felipepipe18/openesc/hardware/projects/OpenESC.sch

## KiCad design hardware/projects/OpenESC.sch (2012-09-12)

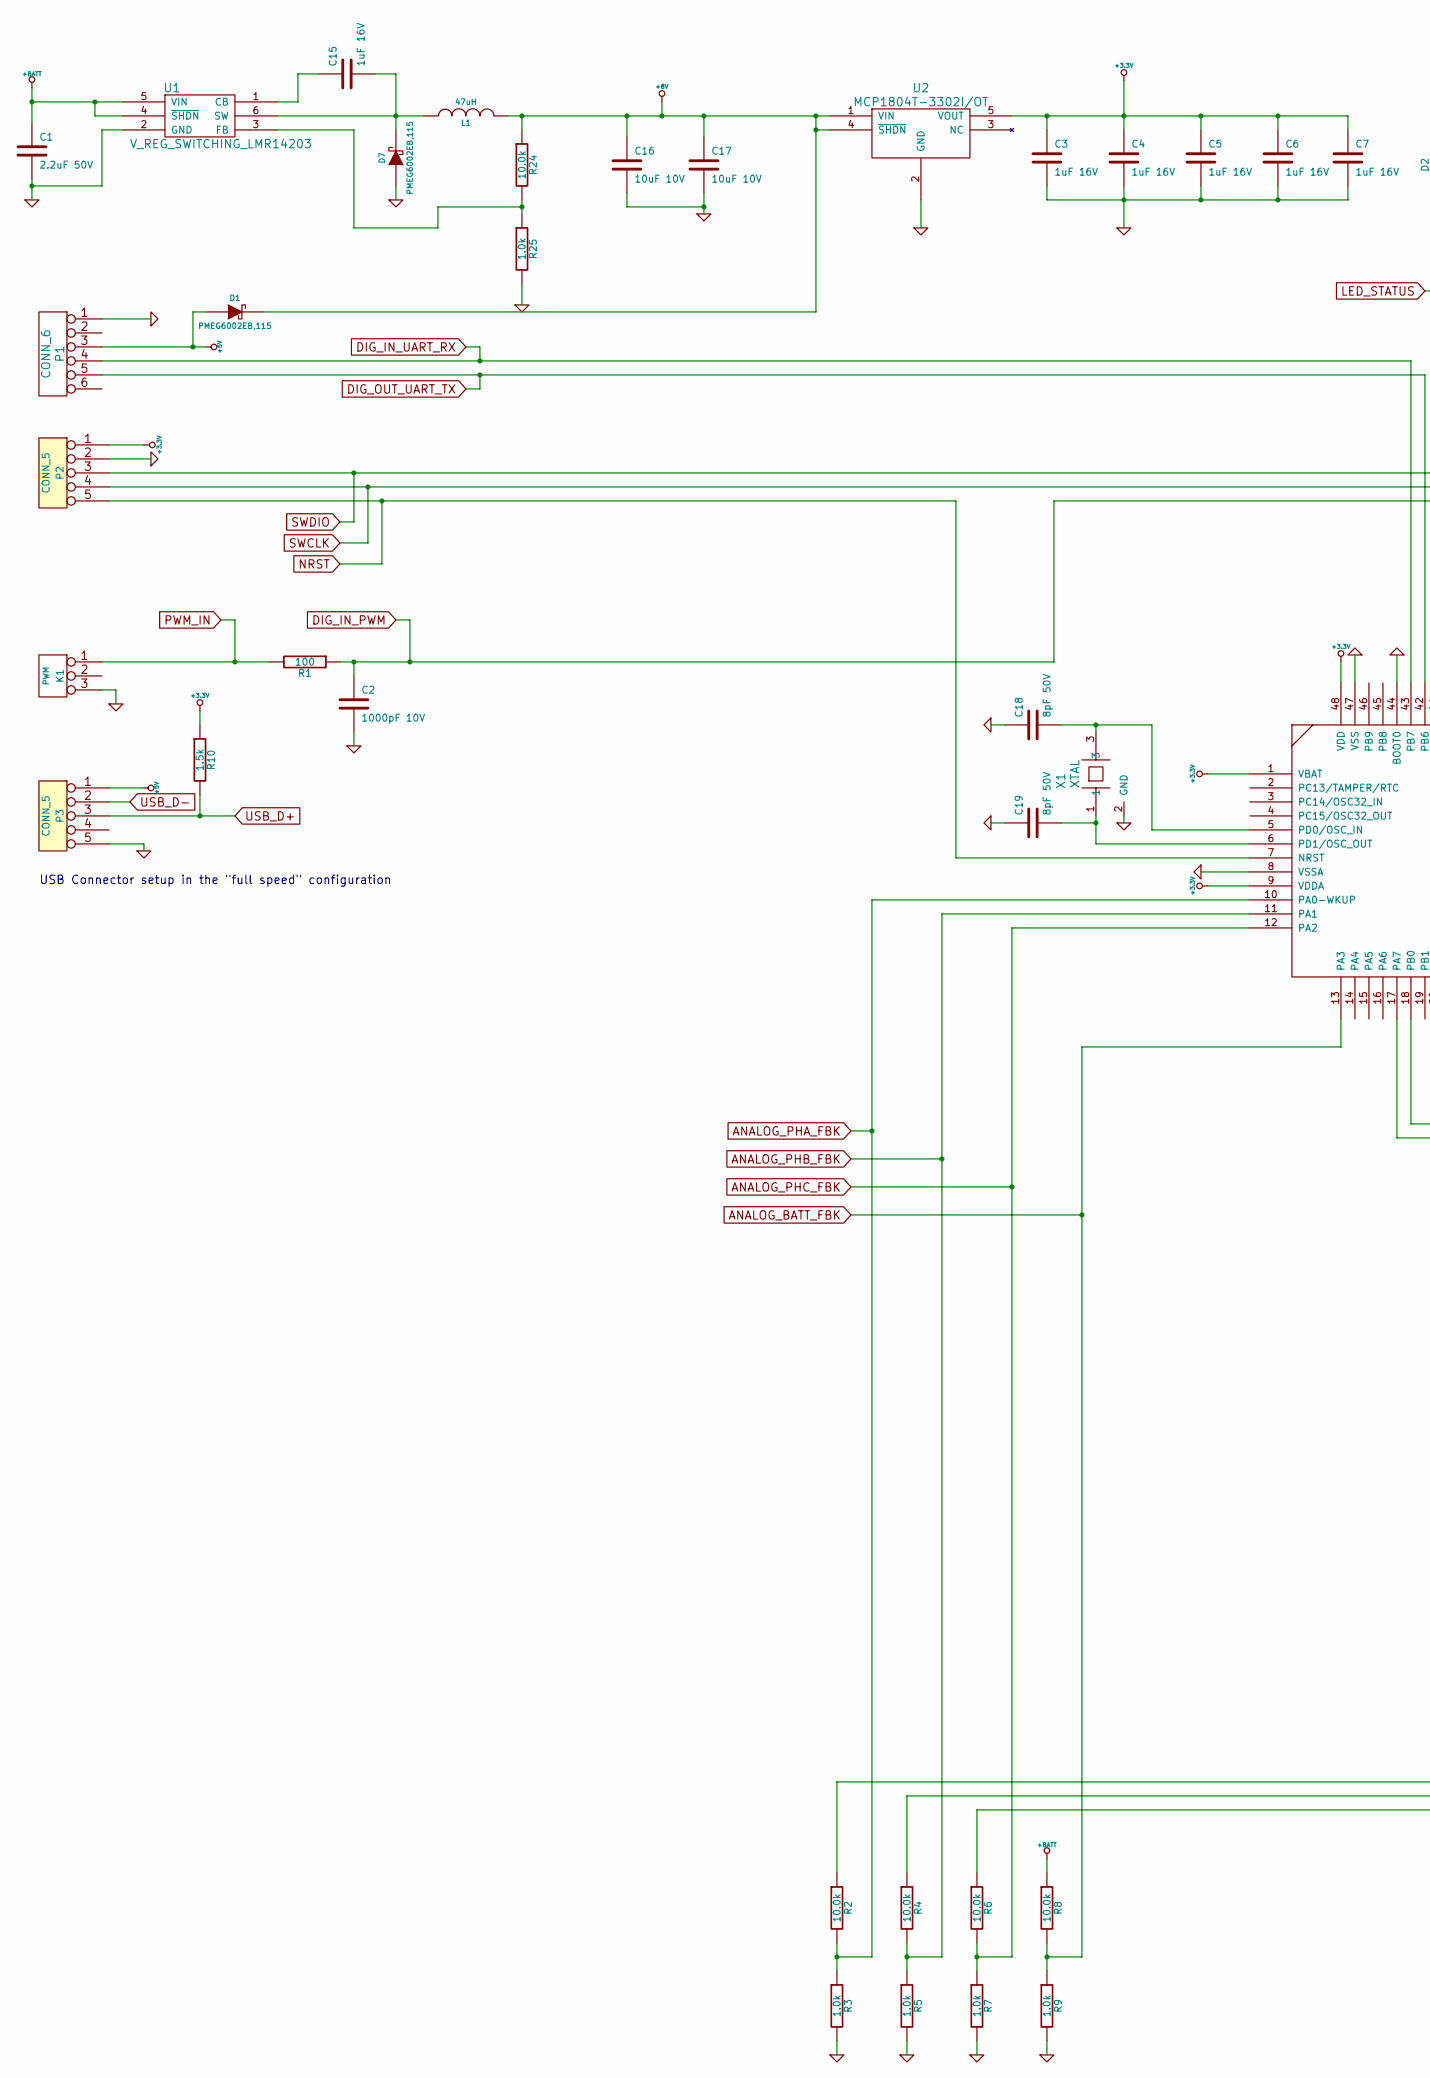
[picture p1: schematic OpenESC.sch, part in row 1, column 1]

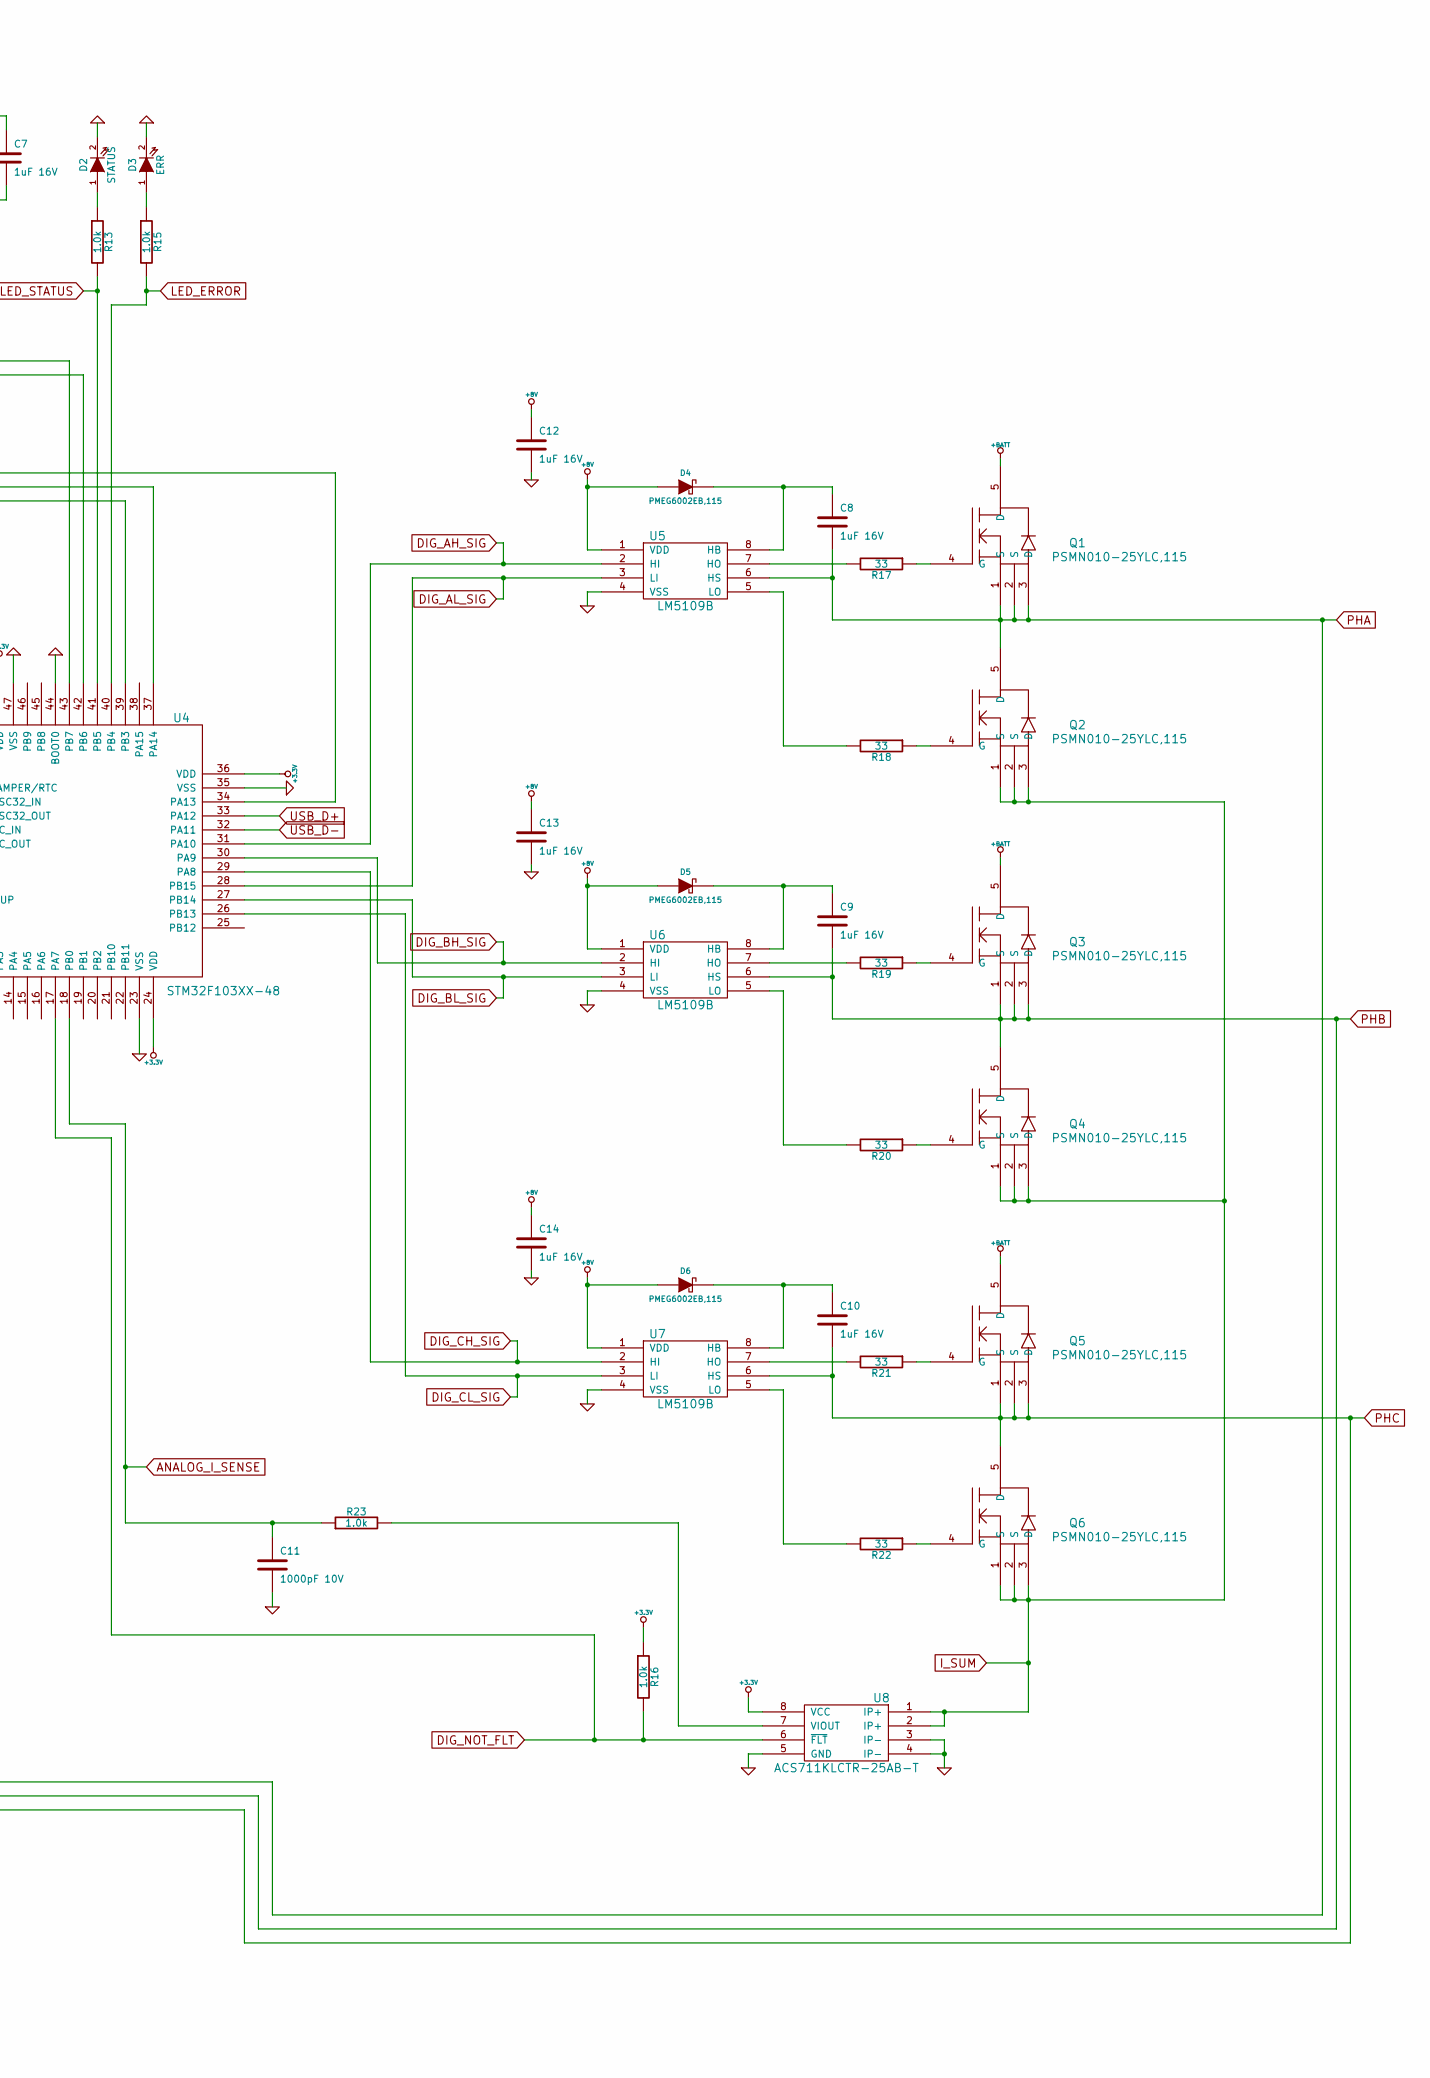
[picture p2: schematic OpenESC.sch, part in row 1, column 2]

Parts:
C1: 2.2uF 50V; SM0805; Man. Part Number C2012Y5V1H225Z
C2: 1000pF 10V; SM0402; Man. Part Number C0402X5R1A102K
C3, C4, C5, C6, C7, C8, C9, C10, C12, C13, C14, C15: 1uF 16V; SM0402; Man. Part Number C1005X5R1C105K
C11: 1000pF 10V; Man. Part Number C0402X5R1A102K
C16, C17: 10uF 10V; SM0805; Man. Part Number C2012Y5V1A106Z
C18, C19: 8pF 50V; SM0402; Man. Part Number CGA2B2C0G1H080D
D1, D4, D5, D6, D7: PMEG6002EB,115; SOD-523; Man. Part Number PMEG6002EB,115
D2: STATUS; SM0603_DIODE; Man. Part Number LTST-C190GKT
D3: ERR; SM0603_DIODE; Man. Part Number LTST-C190EKT
K1: PWM; CONN_3_SM
L1: 47uH; SM0805; Man. Part Number CBC2012T470M
P1: CONN_6; CONN_6_SM
P2: CONN_5; CONN_5_SM
P3: CONN_5; USB_MICRO_AB; Man. Part Number ZX62-AB-5PA(11)
Q1, Q2, Q3, Q4, Q5, Q6: PSMN010-25YLC,115; SC-100; Man. Part Number PSMN010-25YLC,115
R1: 100; SM0402; Man. Part Number RC0402FR-07100RL
R2, R4, R6, R8: 10.0k; SM0402; Man. Part Number RC0402FR-0710KL
R3, R5, R7, R9, R13, R15, R16, R23: 1.0k; SM0402; Man. Part Number RC0402FR-071KL
R10: 1.5k; SM0402; Man. Part Number RC0402FR-071K5L
R17, R18, R19, R20, R21, R22: 33; SM0603; Man. Part Number RC0402FR-0733RL
R24: 10.0k; Man. Part Number RC0402FR-0710KL
R25: 1.0k; Man. Part Number RC0402FR-071KL
U1: V_REG_SWITCHING_LMR14203; SOT223; Man. Part Number LMR14203XMKE/NOPB
U2: MCP1804T-3302I/OT; SOT223; Man. Part Number MCP1804T-3302I/OT
U4: STM32F103XX-48; QFP-48; Man. Part Number STM32F103C8T6
U5, U6, U7: LM5109B; SO8N; Man. Part Number LM5109BMA/NOPB
U8: ACS711KLCTR-25AB-T; SO8N; Man. Part Number ACS711KLCTR-25AB-T
X1: XTAL; CRYSTAL_CX2520_SERIES; Man. Part Number CX2520DB16000D0FLJZ1

Connections:
+3.3V: C3.1, C4.1, C5.1, C6.1, C7.1, P2.1, R10.1, R16.1, U2.5 (VOUT), U4.1 (VBAT), U4.9 (VDDA), U4.24 (VDD), U4.36 (VDD), U4.48 (VDD), U8.8 (VCC)
+5V: D1.1 (A), P1.3, P3.1
+8V: C12.1, C13.1, C14.1, C16.1, C17.1, D1.2 (K), D4.1 (A), D5.1 (A), D6.1 (A), L1.2, R24.1, U2.1 (VIN), U2.4 (~SHDN), U5.1 (VDD), U6.1 (VDD), U7.1 (VDD)
+BATT: C1.1, Q1.5 (D), Q3.5 (D), Q5.5 (D), R8.1, U1.4 (~SHDN), U1.5 (VIN)
ANALOG_BATT_FBK: R8.2, R9.1, U4.13 (PA3)
ANALOG_I_SENSE: C11.1, R23.1, U4.18 (PB0)
ANALOG_PHA_FBK: R2.2, R3.1, U4.10 (PA0-WKUP)
ANALOG_PHB_FBK: R4.2, R5.1, U4.11 (PA1)
ANALOG_PHC_FBK: R6.2, R7.1, U4.12 (PA2)
DIG_AH_SIG: U4.31 (PA10), U5.2 (HI)
DIG_AL_SIG: U4.28 (PB15), U5.3 (LI)
DIG_BH_SIG: U4.30 (PA9), U6.2 (HI)
DIG_BL_SIG: U4.27 (PB14), U6.3 (LI)
DIG_CH_SIG: U4.29 (PA8), U7.2 (HI)
DIG_CL_SIG: U4.26 (PB13), U7.3 (LI)
DIG_IN_PWM: C2.1, R1.1, U4.39 (PB3)
DIG_IN_UART_RX: P1.4, U4.43 (PB7)
DIG_NOT_FLT: R16.2, U4.17 (PA7), U8.6 (~FLT)
DIG_OUT_UART_TX: P1.5, U4.42 (PB6)
GND: C1.2, C2.2, C3.2, C4.2, C5.2, C6.2, C7.2, C11.2, C12.2, C13.2, C14.2, C16.2, C17.2, C18.1, C19.1, D2.2 (K), D3.2 (K), D7.1 (A), K1.3, P1.1, P2.2, P3.5, R3.2, R5.2, R7.2, R9.2, R25.2, U1.2 (GND), U2.2 (GND), U4.8 (VSSA), U4.23 (VSS), U4.35 (VSS), U4.44 (BOOT0), U4.47 (VSS), U5.4 (VSS), U6.4 (VSS), U7.4 (VSS), U8.3 (IP-), U8.4 (IP-), U8.5 (GND), X1.2 (GND)
I_SUM: Q2.1 (S), Q2.2 (S), Q2.3 (D), Q4.1 (S), Q4.2 (S), Q4.3 (D), Q6.1 (S), Q6.2 (S), Q6.3 (D), U8.1 (IP+), U8.2 (IP+)
LED_ERROR: R15.2, U4.40 (PB4)
LED_STATUS: R13.2, U4.41 (PB5)
NRST: P2.5, U4.7 (NRST)
unnamed: C8.1, D4.2 (K), U5.8 (HB)
unnamed: C9.1, D5.2 (K), U6.8 (HB)
unnamed: C10.1, D6.2 (K), U7.8 (HB)
unnamed: C15.1, U1.1 (CB)
unnamed: C15.2, D7.2 (K), L1.1, U1.6 (SW)
unnamed: C18.2, U4.5 (PD0/OSC_IN), X1.3
unnamed: C19.2, U4.6 (PD1/OSC_OUT), X1.1
unnamed: D2.1 (A), R13.1
unnamed: D3.1 (A), R15.1
unnamed: Q1.4 (G), R17.1
unnamed: Q2.4 (G), R18.1
unnamed: Q3.4 (G), R19.1
unnamed: Q4.4 (G), R20.1
unnamed: Q5.4 (G), R21.1
unnamed: Q6.4 (G), R22.1
unnamed: R17.2, U5.7 (HO)
unnamed: R18.2, U5.5 (LO)
unnamed: R19.2, U6.7 (HO)
unnamed: R20.2, U6.5 (LO)
unnamed: R21.2, U7.7 (HO)
unnamed: R22.2, U7.5 (LO)
unnamed: R23.2, U8.7 (VIOUT)
unnamed: R24.2, R25.1, U1.3 (FB)
PHA: C8.2, Q1.1 (S), Q1.2 (S), Q1.3 (D), Q2.5 (D), R2.1, U5.6 (HS)
PHB: C9.2, Q3.1 (S), Q3.2 (S), Q3.3 (D), Q4.5 (D), R4.1, U6.6 (HS)
PHC: C10.2, Q5.1 (S), Q5.2 (S), Q5.3 (D), Q6.5 (D), R6.1, U7.6 (HS)
PWM_IN: K1.1, R1.2
SWCLK: P2.4, U4.37 (PA14)
SWDIO: P2.3, U4.34 (PA13)
USB_D+: P3.3, R10.2, U4.33 (PA12)
USB_D-: P3.2, U4.32 (PA11)

Notes on the sheet:
USB Connector setup in the "full speed" configuration
