felipepipe18/openesc/software/cveliscu/STM32CDC/src/main.c

#include <stdio.h>
#include <stdlib.h>
#include <stdint.h>
#include <math.h>

#include "stm32f4xx_conf.h"
#include "stm32f4xx.h"

#include "usbd_cdc_core.h"
#include "usbd_usr.h"
#include "usbd_desc.h"
#include "usbd_cdc_vcp.h"
#include "usb_bsp.h"

__ALIGN_BEGIN USB_OTG_CORE_HANDLE  USB_OTG_dev __ALIGN_END;

// Private function prototypes
void Delay(volatile uint32_t nCount);
void init();

int main(void) {
	init();

	/*
	 * Disable STDOUT buffering. Otherwise nothing will be printed
	 * before a newline character or when the buffer is flushed.
	 */
	setbuf(stdout, NULL);


	while(1) {
		printf("Test!\n");
		USB_OTG_BSP_mDelay(500);
	}

	return 0;
}

void init() {
	SystemInit();

	// ---------- SysTick timer -------- //
	if (SysTick_Config(SystemCoreClock / 1000)) {
		// Capture error
		while (1){};
	}

	// ------------- USB -------------- //
	USBD_Init(&USB_OTG_dev,
	            USB_OTG_FS_CORE_ID,
	            &USR_desc,
	            &USBD_CDC_cb,
	            &USR_cb);
}

/*
 * Dummy function to avoid compiler error
 */
void _init() {

}
