felipepipe18/openesc/software/slightlynybbled/App/Current_Reg.c

// Current_Reg.c

#include <Current_Reg.h>

void	Set_param_curr_reg(Current_Reg_Def *v)
{
  	v->I_ref 		= 0.0;	
	v->I_fb 		= 0;
	v->KtrI			= KTR_CURRENT;				// current transfer ratio
	v->Err			= 0.0;
	v->Kp			= 0.1;					// Parameter: Proportional gain
	v->Up			= 0.0;					// Variable: Proportional output
	v->Ui			= 0.0;					// Variable: Integral output
	v->Ud			= 0.0;					// Variable: Derivative output
	v->OutPreSat 	= 0.0; 						// Variable: Pre-saturated output
	v->OutMax		= CURRENT_MAX;   			// Parameter: Maximum output
	v->OutMin		= 0.0;	  		  		// Parameter: Minimum output
	v->Out			= 0.0;   				// Output: PID output
	v->SatErr		= 0.0;					// Variable: Saturated difference
	v->Ki			= 0.1;		    			// Parameter: Integral gain
	v->Kc			= 1.0;		     			// Parameter: Integral correction gain
	v->Kd			= 0.0; 			    		// Parameter: Derivative gain
	v->Up1			= 0.0;		   			// History: Previous proportional output
	v->KtrPWM		= F_CLK / (F_SWITCH * CURRENT_MAX);	// conversion factor in the duration of the PWM
	v->UnsOut		= 0;					// PID output
}

void	Calc_current_reg(Current_Reg_Def *v)
{
 	// Compute the error
    v->Err = v->I_ref - ((float)v->I_fb * v->KtrI);

    // Compute the proportional output
    v->Up = v->Kp * v->Err;

    // Compute the integral output
    v->Ui = v->Ui + v->Ki * v->Up + v->Kc * v->SatErr;

    // Compute the derivative output
    v->Ud = v->Kd * (v->Up - v->Up1);

    // Compute the pre-saturated output
    v->OutPreSat = v->Up + v->Ui + v->Ud;

    // Saturate the output
    if (v->OutPreSat > v->OutMax)
      v->Out =  v->OutMax;
    else if (v->OutPreSat < v->OutMin)
      v->Out =  v->OutMin;
    else
      v->Out = v->OutPreSat;

    // Compute the saturate difference
    v->SatErr = v->Out - v->OutPreSat;

    // Update the previous proportional output
    v->Up1 = v->Up;
	
	// Calc out
    v->UnsOut = (uint16_t)(v->Out * v->KtrPWM);
	
    if (v->UnsOut >= 350)
      v->UnsOut = 350;
	
}
