felipepipe18/openesc/software/gpio.c

/**************************************************
 * Copyright 2012 OpenESC
 *
 * This file is part of OpenESC
 *
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
 * You should have received a copy of the GNU
 *	General Public License along with OpenESC. If
 *	not, see http://www.gnu.org/licenses/.
*************************************************/

#include "gpio.h"

void
GPIO_pinSetup(uint16_t port, uint16_t pin, uint8_t pinState)
{
	switch(port)
	{
		case GPIO_PORT_A:
		{
			if((pin >= 0) && (pin <= 7)){
				// clear the appropriate bits, then set the appropriate bits
				GPIOA->CRL &= (uint32_t)~(0b1111 << (pin * 4));
				GPIOA->CRL |= (uint32_t)(pinState << (pin * 4));
			}else if((pin >= 8) && (pin <= 15)){
				// clear the appropriate bits, then set the appropriate bits
				GPIOA->CRH &= (uint32_t)~(0b1111 << ((pin - 8) * 4));
				GPIOA->CRH |= (uint32_t)(pinState << ((pin - 8) * 4));
			}else{
				/*
				 * This is a programmer's trap.  If the code gets to this while loop,
				 * then an invalid pin within this port has been specified.
				 */
				while(1);
			}
			break;
		}
		case GPIO_PORT_B:
		{
			if((pin >= 0) && (pin <= 7)){
				// clear the appropriate bits, then set the appropriate bits
				GPIOB->CRL &= (uint32_t)~(0b1111 << (pin * 4));
				GPIOB->CRL |= (uint32_t)(pinState << (pin * 4));
			}else if((pin >= 8) && (pin <= 15)){
				// clear the appropriate bits, then set the appropriate bits
				GPIOB->CRH &= (uint32_t)~(0b1111 << ((pin - 8) * 4));
				GPIOB->CRH |= (uint32_t)(pinState << ((pin - 8) * 4));
			}else{
				/*
				 * This is a programmer's trap.  If the code gets to this while loop,
				 * then an invalid pin within this port has been specified.
				 */
				while(1);
			}

			break;
		}
		default:
		{
			/*
			 * This is a programmer's trap.  If the code gets to this while loop,
			 * then an invalid port has been specified.
			 */
			while(1);
			break;
		}
	}
}

void
GPIO_setOutputPin(unsigned int port, unsigned int pin)
{
	switch(port)
	{
		case GPIO_PORT_A:
		{
			//GPIOA->BSSR |= (uint32_t)(0b1 << pin);
			GPIOA->ODR |= (uint32_t)(0b1 << pin);

			break;
		}

		case GPIO_PORT_B:
		{
			//GPIOB->BSSR |= (uint32_t)(0b1 << pin);
			GPIOB->ODR |= (uint32_t)(0b1 << pin);

			break;
		}
	}
}

void
GPIO_clearOutputPin(unsigned int port, unsigned int pin)
{
	switch(port)
	{
		case GPIO_PORT_A:
		{
			//GPIOA->BSSR |= (uint32_t)(0b1 << (pin + 16));
			GPIOA->ODR &= (uint32_t)~(0b1 << pin);

			break;
		}

		case GPIO_PORT_B:
		{
			//GPIOB->BSSR |= (uint32_t)(0b1 << (pin + 16));
			GPIOB->ODR &= (uint32_t)~(0b1 << pin);

			break;
		}
	}
}

bool
GPIO_readInput(unsigned int port, unsigned int pin)
{
	bool pinState = 0;

	switch(port)
	{
		case GPIO_PORT_A:
		{
			pinState = (bool)((GPIOA->IDR & (uint32_t)(0b1 << pin)) >> pin);
			break;
		}

		case GPIO_PORT_B:
		{
			pinState = (bool)((GPIOB->IDR & (uint32_t)(0b1 << pin)) >> pin);

			break;
		}
}

	return pinState;
}
