felipepipe18/openesc/(commit log)

2012-09-10 Separating software from hardware components using directories
    [OpenESC_00-Back.gbl, OpenESC_00-Front.gtl, OpenESC_00-Inner2.gbr, OpenESC_00-Inner3.gbr, OpenESC_00-Mask_Back.gbs, OpenESC_00-Mask_Front.gts, OpenESC_00-PCB_Edges.gbr, OpenESC_00-SilkS_Back.gbo]
2012-09-11 Changed usb library to remove bottom mask
    [OpenESC_00-Back.gbl, OpenESC_00-Front.gtl, OpenESC_00-Inner2.gbr, OpenESC_00-Inner3.gbr, OpenESC_00-Mask_Back.gbs, OpenESC_00-Mask_Front.gts, OpenESC_00-PCB_Edges.gbr, OpenESC_00-SilkS_Back.gbo]
2012-09-12 Removing trailing 00 that was being used as a version placeholder before version control was implemented. Files are exactly the same as before, simply renamed.
    [$OpenESC.sch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]
2012-09-12 Same as previous - received a bad save message from KiCad, so I'm re-committing.
    [$OpenESC.sch, OpenESC.sch]
2012-09-13 Added GPLv3 message to a couple of files and added the license itself at the root directory.
2012-09-14 Added some pin definitions to the board c and h files
2012-09-16 Downloaded changes from repo that add several files such as motor.c, rcpwm.c, etc.
2012-09-18 Added crystal and USB micro AB 3D models.
    [OpenESC.brd]
2012-09-22 Slightly changed rcPwm.h and rcPmw.c to be a bit smaller and to take advantage of fractional fixed point division to determine the rc pulse width as a fraction of the max pulse width measured during 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
    [motPwm.c, rcPwm.c, rcPwm.h]
2012-09-23 Added motorPwm files. Need to add more, but this is a start.
2012-09-23 Removed a couple of unnecessary files. Added code to motPwm.c and motPwm.h. Both still need a lot of work.
2012-09-23 Beginning to flesh out the motor control code now - need to add an ADC interrupt to read the phases and commutate the motor appropriately.
2012-09-23 - Added structs to motPwm and motor files that allow the software to become more aware of its current state, such as what phase is operating at what time. More variables will be added to both of thes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
2012-09-24 Cleaned up rcPwm module - Fixed a couple of typos - Added prescaler - Added reasaonalbe start and stop values for the longest and shortest time measured - Added a pulse width verification so that a p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
    [openesc_v01.c, rcPwm.c, rcPwm.h]
2012-09-24 Added a milli second timer amongst several other small changes.
2012-09-26 Updated motPwm.c to create an event trigger on CCP4 for the ADC to use (ADC not coded yet)
2012-09-27 Got a start on ADC configuration. Still needs a lot of work.
2012-09-28 Added NVIC configuration to assign interrupts to ADC1/ADC2 and TIM3
2012-09-30 Added a commutate() function, which should look at the current sector and move the motor to the next sector. This routine should be very fast since it uses lookup tables and performs very little calc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
2012-09-30 Added comments to motor.c functions
2012-10-02 Added an internal oscillator setup. Will likely need to adjust several of the other modules, but only slightly.
    [motPwm.c, motPwm.h, openesc_v01.c, openesc_v01.h]
2012-10-02 Starting some very basic debugging. Fixed a couple of errant register loads.
    [motPwm.c, openesc_v01.c]
2012-11-17 create bldc_backemf
2012-12-15 Tool for sending debug commands over serial port.
    Requires .NET Framework 3.5
2013-01-28 Added STM32 USB Virtual COM Port ported to CooCox
