felipepipe18/openesc/(notices)

Notices in the files:
software/motor.c:
General Public License as published by the
Free Software Foundation, either version 3 of
the License, or (at your option) any later
